orsty3001/Basic-AGM-Lead-Acid-Battery-Float-Charger/images/Solar Float Charger PCB REV_B.png

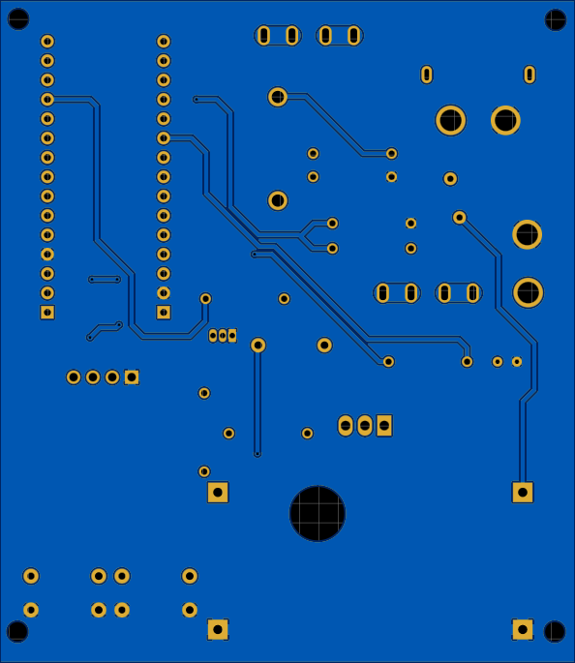
images/Solar Float Charger PCB REV_B.png
