orsty3001/Basic-AGM-Lead-Acid-Battery-Float-Charger/images/Solar Float Charger PCB top REV_B.png

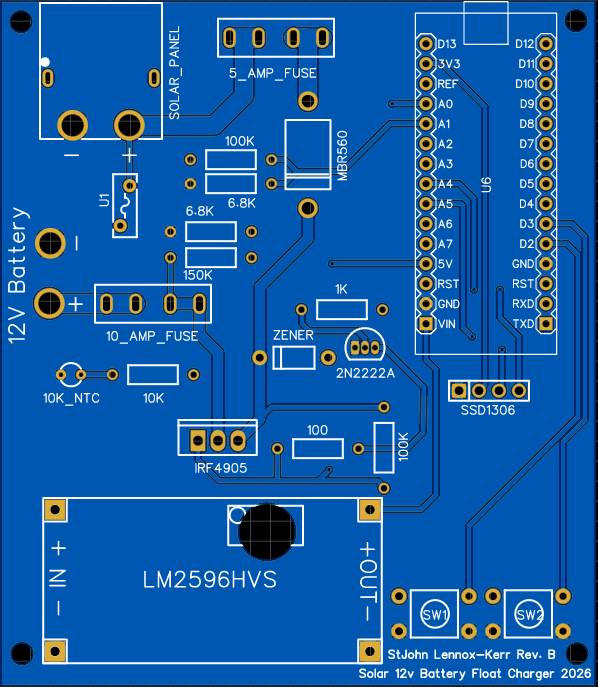
images/Solar Float Charger PCB top REV_B.png
