orsty3001/Basic-AGM-Lead-Acid-Battery-Float-Charger/docs/Solar_Float_Charger_MOSFET_BOM.xlsx

Category | Qty | Part | Specification | Recommended
Power Path | 1 | Schottky Blocking Diode | ≥5A, ≥45V, low Vf | MBR560 / SR560 / SS54
Power Path | 1 | Inline Fuse Holder | ATO/ATC | SL-506P | https://www.amazon.com/dp/B08GSG1FNV?ref=ppx_yo2ov_dt_b_fed_asin_title | https://www.fusesholder.com/quality-14138391-pcb-mount-sl-506p-mini-fuse-block-blade-fuse-holder-for-297-atm-fuses
Power Path | 1 | Automotive Fuse | 5A ATO/ATC | Standard
Power Path | 1 | P-Channel MOSFET | ≥55V, low Rds(on), logic-level | IRF4905
Power Path | 1 | MOSFET Heatsink | Clip-on or screw-on | Aavid/CTS 529802B02500
Power Path | 1 | Thermal Pad/Insulator | Optional | Bergquist Sil-Pad / mica
Voltage Sensing | 1 | Resistor 100kΩ 1% | Divider R2 | Metal Film
Voltage Sensing | 1 | Resistor 150kΩ 1% | Divider R1 | Metal Film
Voltage Sensing | 2 | Resistor 6.8kΩ 1% | Divider R1 & R2 | Metal Film
Voltage Sensing | 1 | Resistor 10kΩ 1% | NTC divider fixed resistor | Metal Film
Temperature | 1 | 10k NTC Thermistor | B≈3950 | TDK/EPCOS B57861S0103F040
Gate Network | 1 | Gate Resistor | 100Ω | Metal Film
Gate Network | 1 | Gate Pull-Up Resistor | 100kΩ | Metal Film
Gate Network | 1 | NPN Transistor | Gate driver | 2N2222 / BC337
Gate Network | 1 | Base Resistor | 1kΩ | Metal Film
Gate Network | 1 | Zener Diode | 12V, 1W | 1N4742A
UI | 1 | OLED Display | SSD1306 128x64 I2C | Generic
UI | 2 | Momentary Pushbuttons | NO, panel mount | Generic
Enclosure | 1 | Project Box | ABS/Polycarbonate | Hammond 1591 / 1554
Wiring | 1 | Power Wire | 14–16 AWG | Automotive
Wiring | 1 | Signal Wire | 22 AWG | Stranded
Terminations | 1 | Ring/Fork Terminals | Assorted | 3M / TE | You can also find alligator clips to connect to a battery with.
Power Plug | 1 | XT60 90 degree | 90 Degree | Generic | https://www.amazon.com/dp/B09XTN9N9S?ref=ppx_yo2ov_dt_b_fed_asin_title
