orsty3001/Basic-AGM-Lead-Acid-Battery-Float-Charger/(commit log)

2026-01-18 Add files via upload
    Changelog — Latest Code Revision (PWM Solar Float Charger, Nano + SSD1306)
    Added
    Dual calibration paths (Battery vs PV):
    Introduced separate calibration variables:
    cal_scale_bat, cal_offset_bat
    cal_scale_pv, cal_offset_pv
    Updated voltage conversion to accept per-channel calibration:
    dividerVoltage(adc, R1, R2, scale, offset)
    Expanded EEPROM layout to support PV calibration:
    Added EEPROM slots for PV scale/offset.
    Preserved existing storage for battery profile selection, charger profiles, and temperature unit.
    Run-screen battery mode switching + CAL menu entry (Button 1):
    Short press toggles FLA ⇄ AGM and persists to EEPROM.
    Long p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
    [12v_Solar_Battery_Float_Charger.ino]
2026-01-18 Add files via upload
    Updated BOM.
    - Added 150k Resistor
    - Added XT60 90 Degree connector for the solar panel.
    [Solar_Float_Charger_MOSFET_BOM.xlsx]
